EEETeamMinion/Year1Project/Magnetism/hall_sensor_absent.jpg

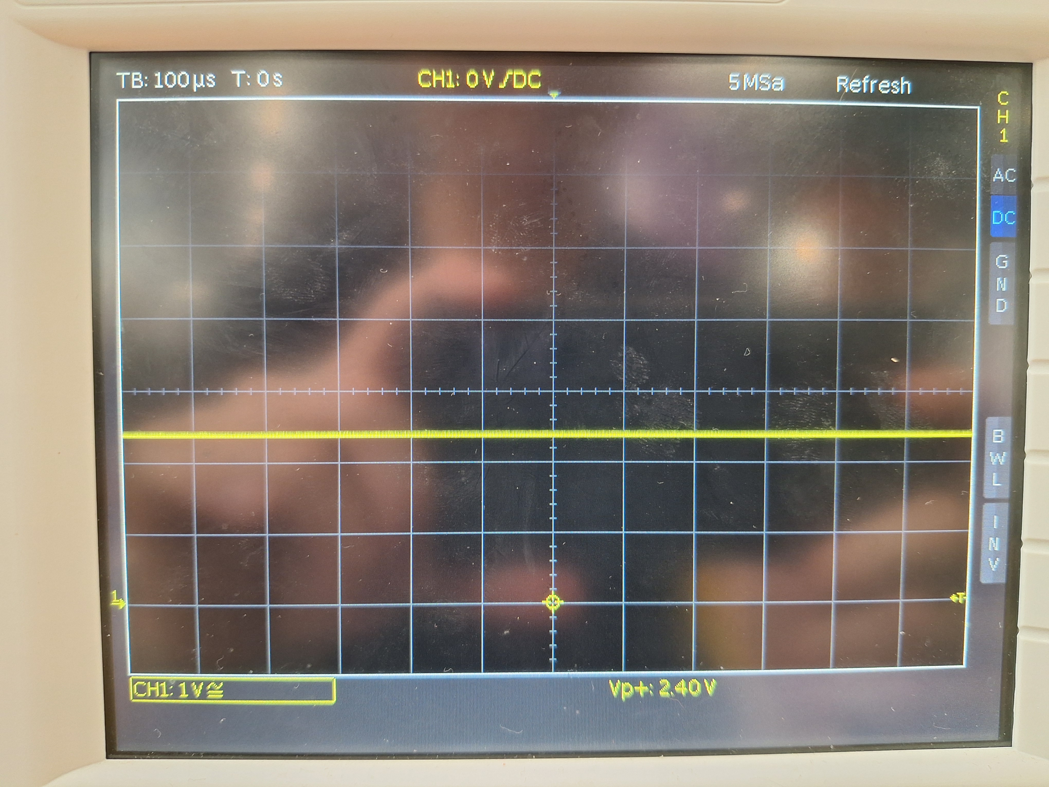
Magnetism/hall_sensor_absent.jpg
