EEETeamMinion/Year1Project/Magnetism/hall_sensor_down.jpg

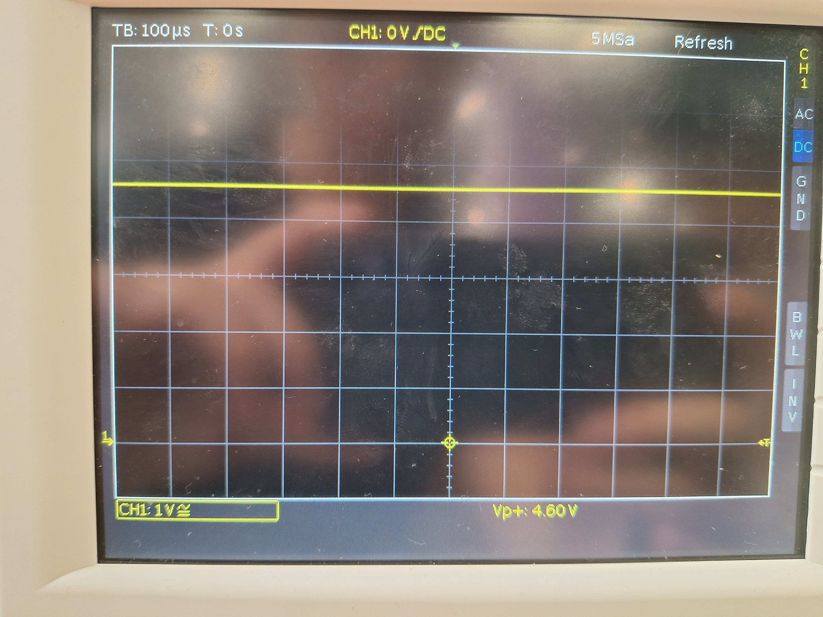
Magnetism/hall_sensor_down.jpg
