EEETeamMinion/Year1Project/Magnetism/hall_sensor_up.jpg

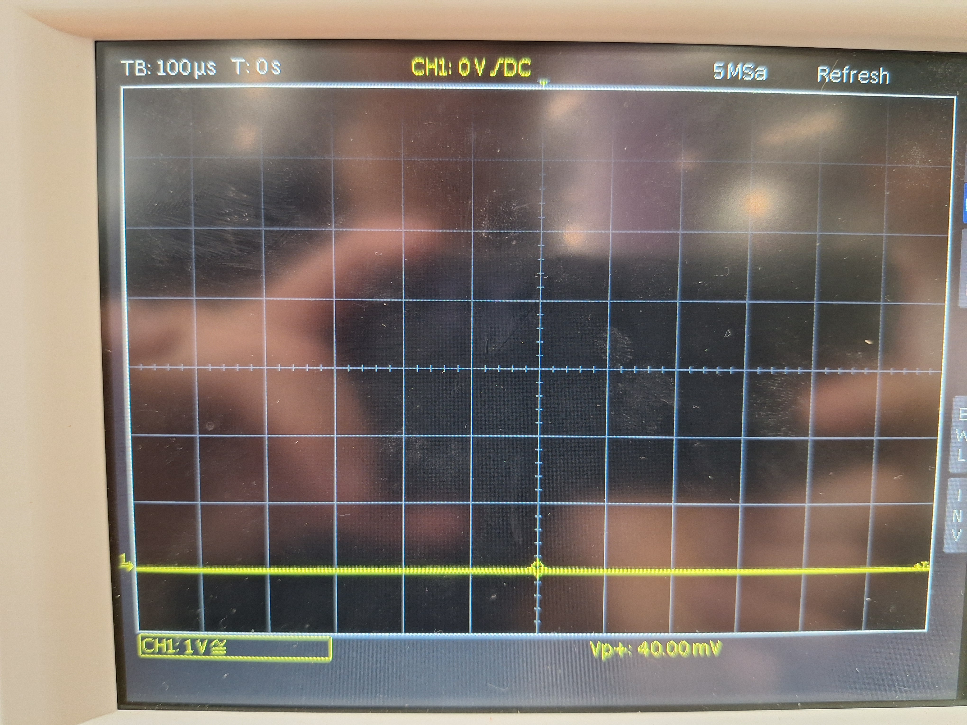
Magnetism/hall_sensor_up.jpg
