EEETeamMinion/Year1Project/Magnetism/summer project - magnetism schmitt trigger (final).asc

C1: cap; 100n
R3: res; 5.1k
R4: res; 5.1k
Rf: res; 2Meg
Rin: res; 10k
U1: LT1366
V1: voltage; 3.3
Vcc: voltage; 5
Vin: voltage; SINE(2.5 2.25 100)
Named nets: 0, Vout
.tran 100m
