EEETeamMinion/Year1Project/Magnetism/summer project - magnetism schmitt trigger (initial).asc

R3: res; 5.1k
R4: res; 5.1k
Rf: res; 150k
Rin: res; 10k
U1: LT1366
V1: voltage; 3
Vcc: voltage; 5
Vin: voltage; SINE(2.5 2.25 100)
Named nets: 0, Vout
.tran 100m
