EEETeamMinion/Year1Project/Ultrasound/Amplification.asc

R1: res; 1k
R2: res; 150k
U1: UniversalOpAmp
V1: voltage; SINE(0 20m 40000); AC 1
V2: voltage; 5
Named nets: 0, Vout
.tran 1m
