EEETeamMinion/Year1Project/Ultrasound/Bandpass filter ultrasound.asc

C1: cap; 1n
C2: cap; 1n
R1: res; 4.3k
R2: res; 3.9k
V1: voltage; ""; AC 1
Named nets: Vout, 0
.ac dec 100 10 100k
