EEETeamMinion/Year1Project/Ultrasound/Comparator.asc

R1: res; 12k
R2: res; 1k
R3: res; 390k
R4: res; 10k
R5: res; 2k
R6: res; 3k
U1: LT1366
V1: voltage; SINE(0 3 10); AC 1
V2: voltage; 5
Named nets: 0
.tran 0.5
.ac dec 100 10 100k
