EEETeamMinion/Year1Project/Ultrasound/Envelope Detector.asc

C1: cap; 10n
D1: diode; 1N4148
R1: res; 10k
V1: voltage; SINE(0 1 40000)
Named nets: 0, Vout
.tran 120u
