EEETeamMinion/Year1Project/Ultrasound/Full wave precision rectifier.asc

D1: diode; 1N4148
D2: diode; 1N4148
R1: res; 6.8k
R2: res; 6.8k
R3: res; 3.4k
R4: res; 6.8k
R5: res; 6.8k
U1: UniversalOpAmp
U2: UniversalOpAmp
V1: voltage; SINE(0 1 1000)
V2: voltage; 5
Named nets: 0, Vout
Gain of first opamp is R5/R3
Gain of second opamp is R5/R4
Total gain is sum of gains
This is set as an inverting amplifier
Requires high slew rate opamp (> 1V/us)
If input is X, we get:
Y = -(-(R5/R3)X + (R5/R4)X)
.tran 5m
