EEETeamMinion/Year1Project/Ultrasound/Sallen Key Filter.asc

C1: cap; 1n
C2: cap; 1n
C3: cap; 1n
C4: cap; 1n
R1: res; 4300
R2: res; 4300
R3: res; 3900
R4: res; 3900
U1: UniversalOpAmp
U2: UniversalOpAmp
V1: voltage; ""; AC 1
V2: voltage; 5
Named nets: 0, Vout
.ac dec 100 10 100k
