EEETeamMinion/Year1Project/Ultrasound/Ultrasonic Full Circuit Double Amplifier.asc

C1: cap; 1n
C2: cap; 1n
C3: cap; 10n
D1: diode
R1: res; 100k
R2: res; 1k
R3: res; 4.3k
R4: res; 3.9k
R5: res; 10k
R6: res; 9.1k
R7: res; 1k
R8: res; 47k
R9: res; 3k
R10: res; 180k
R11: res; 3k
R12: res; 2k
R13: res; 3k
U1: UniversalOpAmp
U2: UniversalOpAmp
U3: LT1366
V1: voltage; SINE(0 35m 40000); AC 1
V2: voltage; 5
V3: voltage; 5
Named nets: 0, Vamp, Vrect, Vout
.tran 250u
