EEETeamMinion/Year1Project/Ultrasound/Ultrasonic Full Circuit FINAL.asc

C1: cap; 0.1n
C2: cap; 0.1n
C3: cap; 10n
D1: diode
R1: res; 99k
R2: res; 1k
R3: res; 43k
R4: res; 39k
R5: res; 10k
R6: res; 16k
R7: res; 1k
R8: res; 390k
R9: res; 10k
R10: res; 2k
R11: res; 3k
U1: UniversalOpAmp
U2: LT1366
V1: voltage; SINE(0 35m 40000); AC 1
V2: voltage; 5
V4: voltage; 5
Named nets: 0, Vamp, Vrect, Vout
.tran 250u
