EEETeamMinion/Year1Project/Ultrasound/Ultrasonic Full Circuit v4.asc

C1: cap; 0.1n
C2: cap; 0.1n
C3: cap; 10n
D1: diode; 1N4148
D2: diode; 1N4148
R1: res; 49k
R2: res; 1k
R3: res; 43k
R4: res; 39k
R5: res; 6.8k
R6: res; 6.8k
R7: res; 3.4k
R8: res; 6.8k
R9: res; 6.8k
R10: res; 10k
U1: UniversalOpAmp
U2: UniversalOpAmp
U3: UniversalOpAmp
V1: voltage; SINE(0 35m 40000); AC 1
V2: voltage; 5
V4: voltage; 5
Named nets: 0, Vamp, Vout
.tran 250u
