EEETeamMinion/Year1Project/Ultrasound/Ultrasonic Full Circuit.asc

C1: cap; 0.1n
C2: cap; 0.1n
D1: diode; 1N4148
D2: diode; 1N4148
R1: res; 9k
R2: res; 1k
R3: res; 45k
R4: res; 35k
R5: res; 6.8k
R6: res; 6.8k
R7: res; 3.4k
R8: res; 6.8k
R9: res; 6.8k
R10: res; 9k
R11: res; 1k
U1: UniversalOpAmp
U2: UniversalOpAmp
U3: UniversalOpAmp
U4: UniversalOpAmp
V1: voltage; SINE(0 1 40000); AC 1
V2: voltage; 5
V3: voltage; 5
V4: voltage; 5
Named nets: 0, Vamp, Vout
.tran 250u
.ac dec 100 10 100k
