EEETeamMinion/Year1Project/infrared/LTSpice/200x amplification.asc

C1: cap; 1µ
R1: res; 1k
R2: res; 200k
R3: res; 10k
U1: LT1366
V1: voltage; 5
V2: voltage; PULSE(0 20mV 0 0.00001 0.00001 50u 0.01)
V3: voltage; 5
Named nets: 0, Vout
.tran 0.1
