EEETeamMinion/Year1Project/infrared/LTSpice/IR circuit FINAL.asc

C1: cap; 1µ
R7: res; 1k
R8: res; 1k
R10: res; 11k
R11: res; 200k
R12: res; 10k
R15: res; 10k
R16: res; 10k
R17: res; 240k
R18: res; 10k
U3: LT1366
U4: LT1366
V2: voltage; 5
V3: voltage; 5
V6: voltage; PULSE(0 20mV 0 0.00001 0.00001 50u 0.01)
Named nets: 0, vout
.tran 0.1
