EEETeamMinion/Year1Project/infrared/LTSpice/schmitt trigger.asc

R1: res; 1k
R2: res; 11k
R3: res; 10k
R4: res; 10k
R5: res; 10k
R6: res; 240k
U1: LT1366
V1: voltage; 5
Named nets: 0, vout, Vin
