EEETeamMinion/Year1Project/SummerProjectSensorBoard/SummerProjectSensorBoard.kicad_pcb

## KiCad design SummerProjectSensorBoard/SummerProjectSensorBoard.kicad_pcb (2026-06-11)

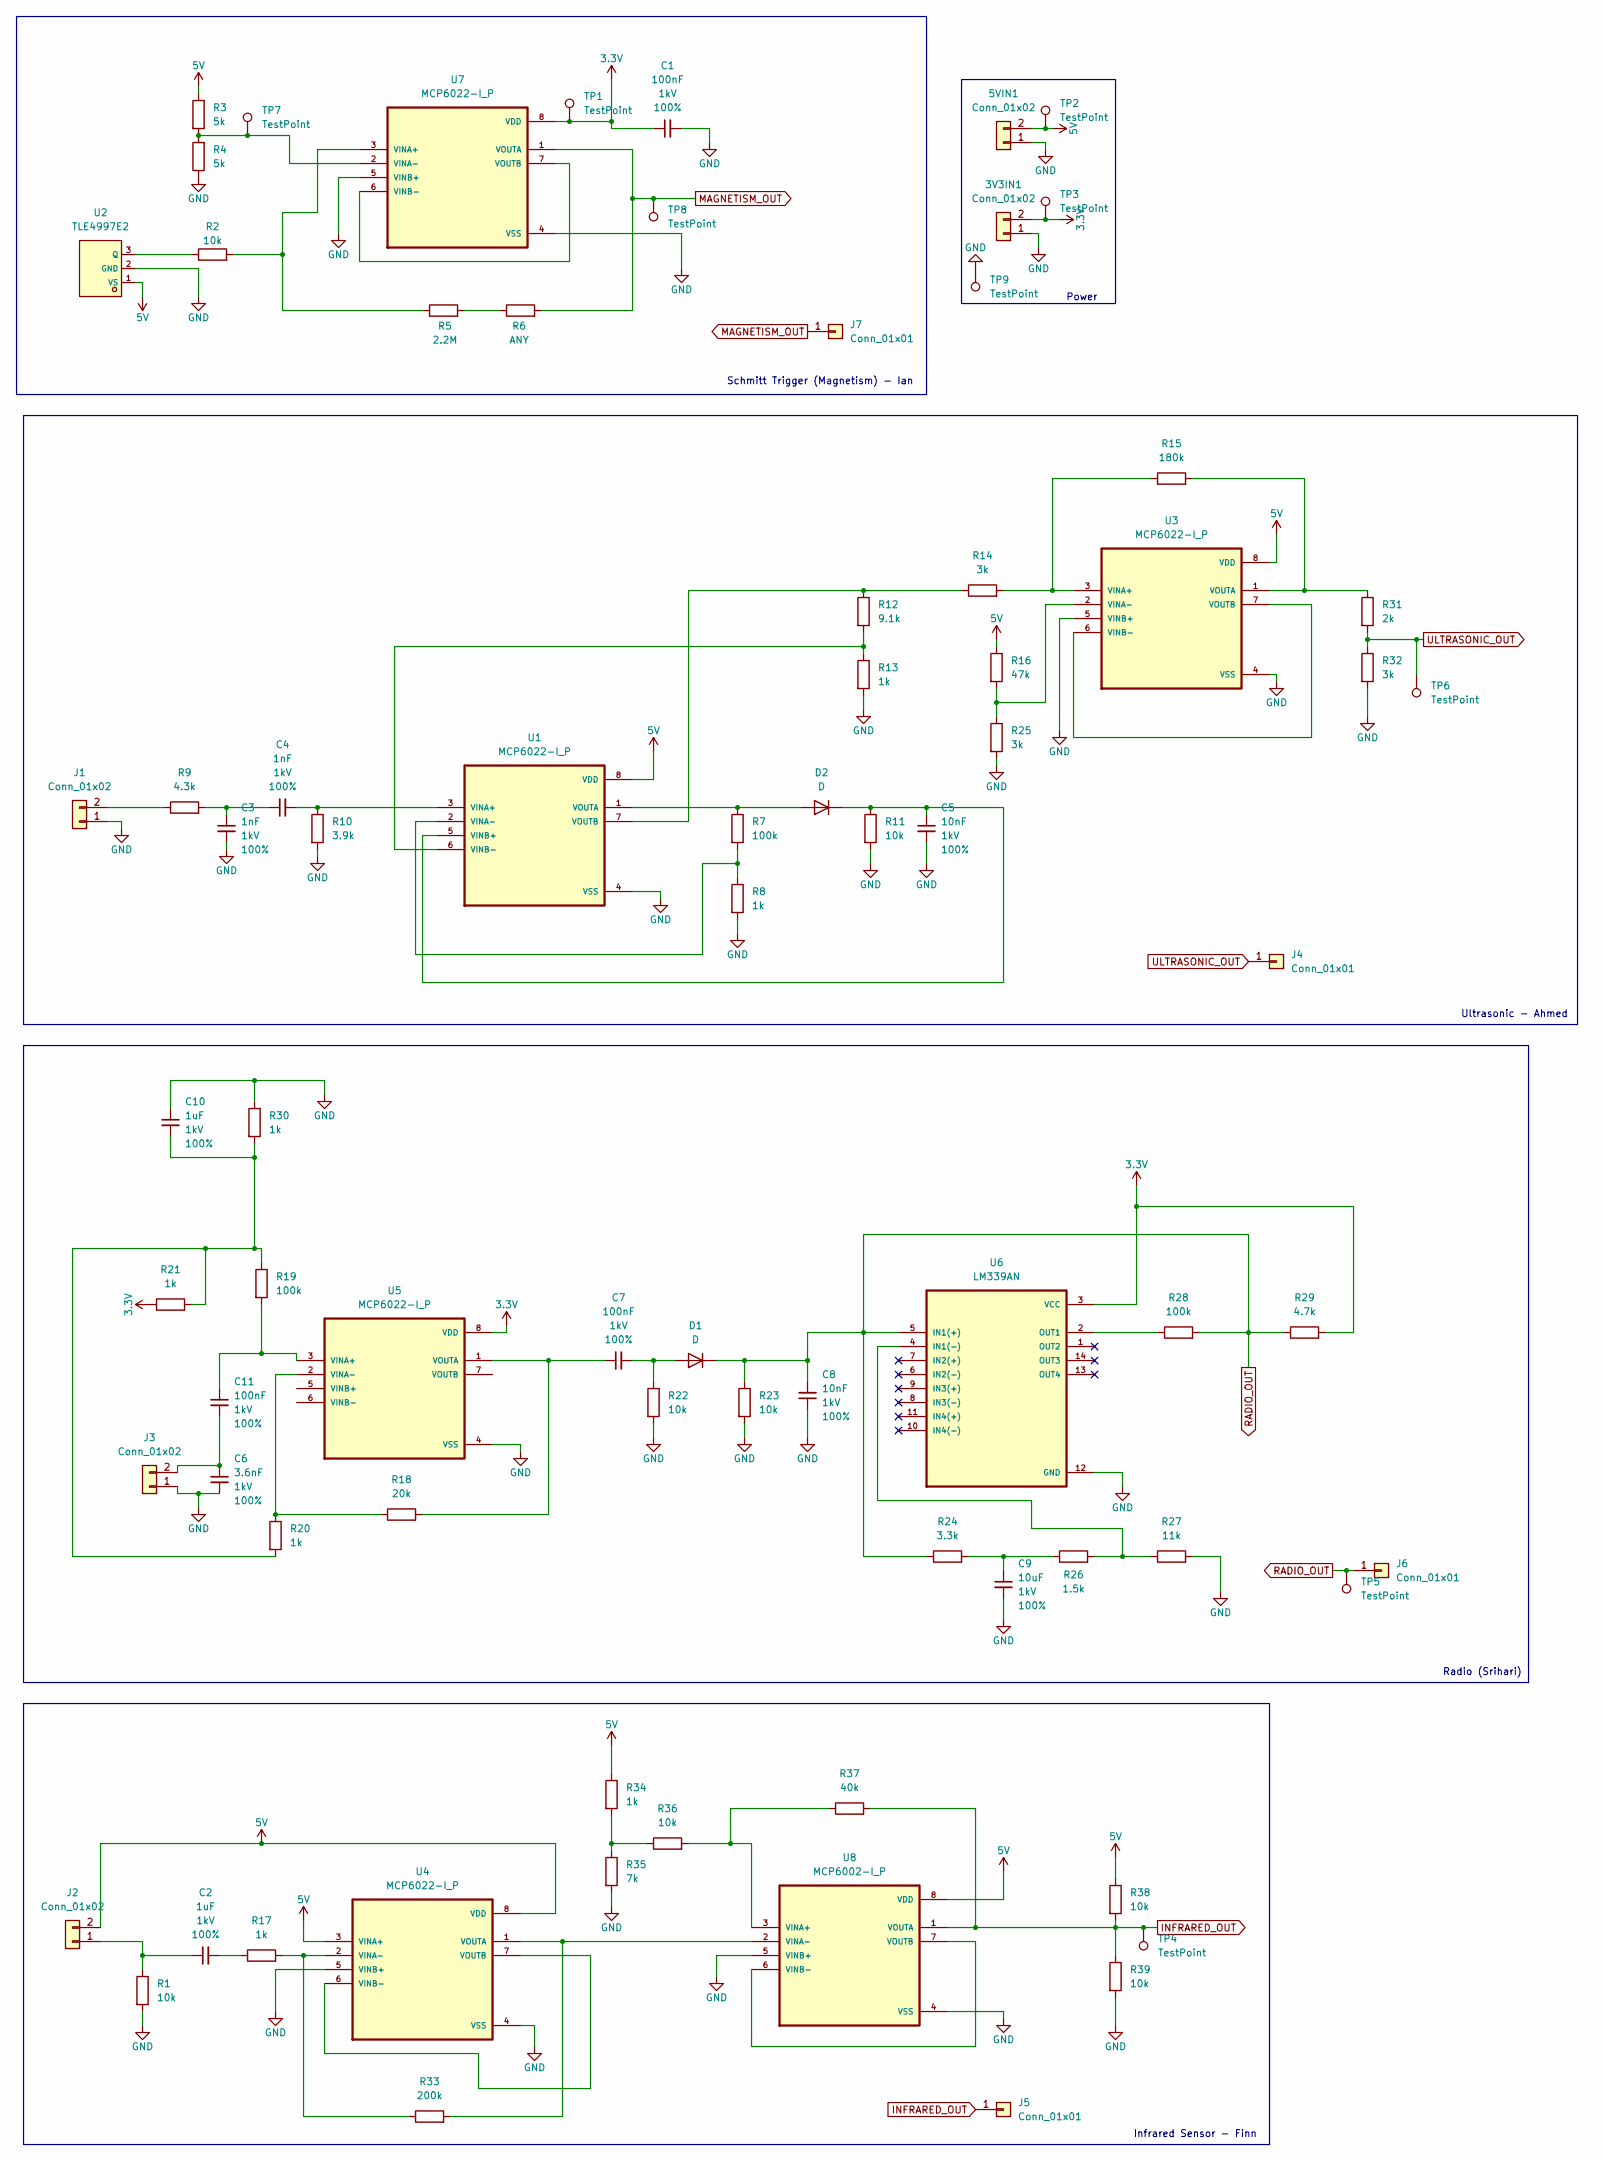
[picture p4: schematic SummerProjectSensorBoard.kicad_sch, EEELunarRover Sensor Board, part in row 1, column 1]

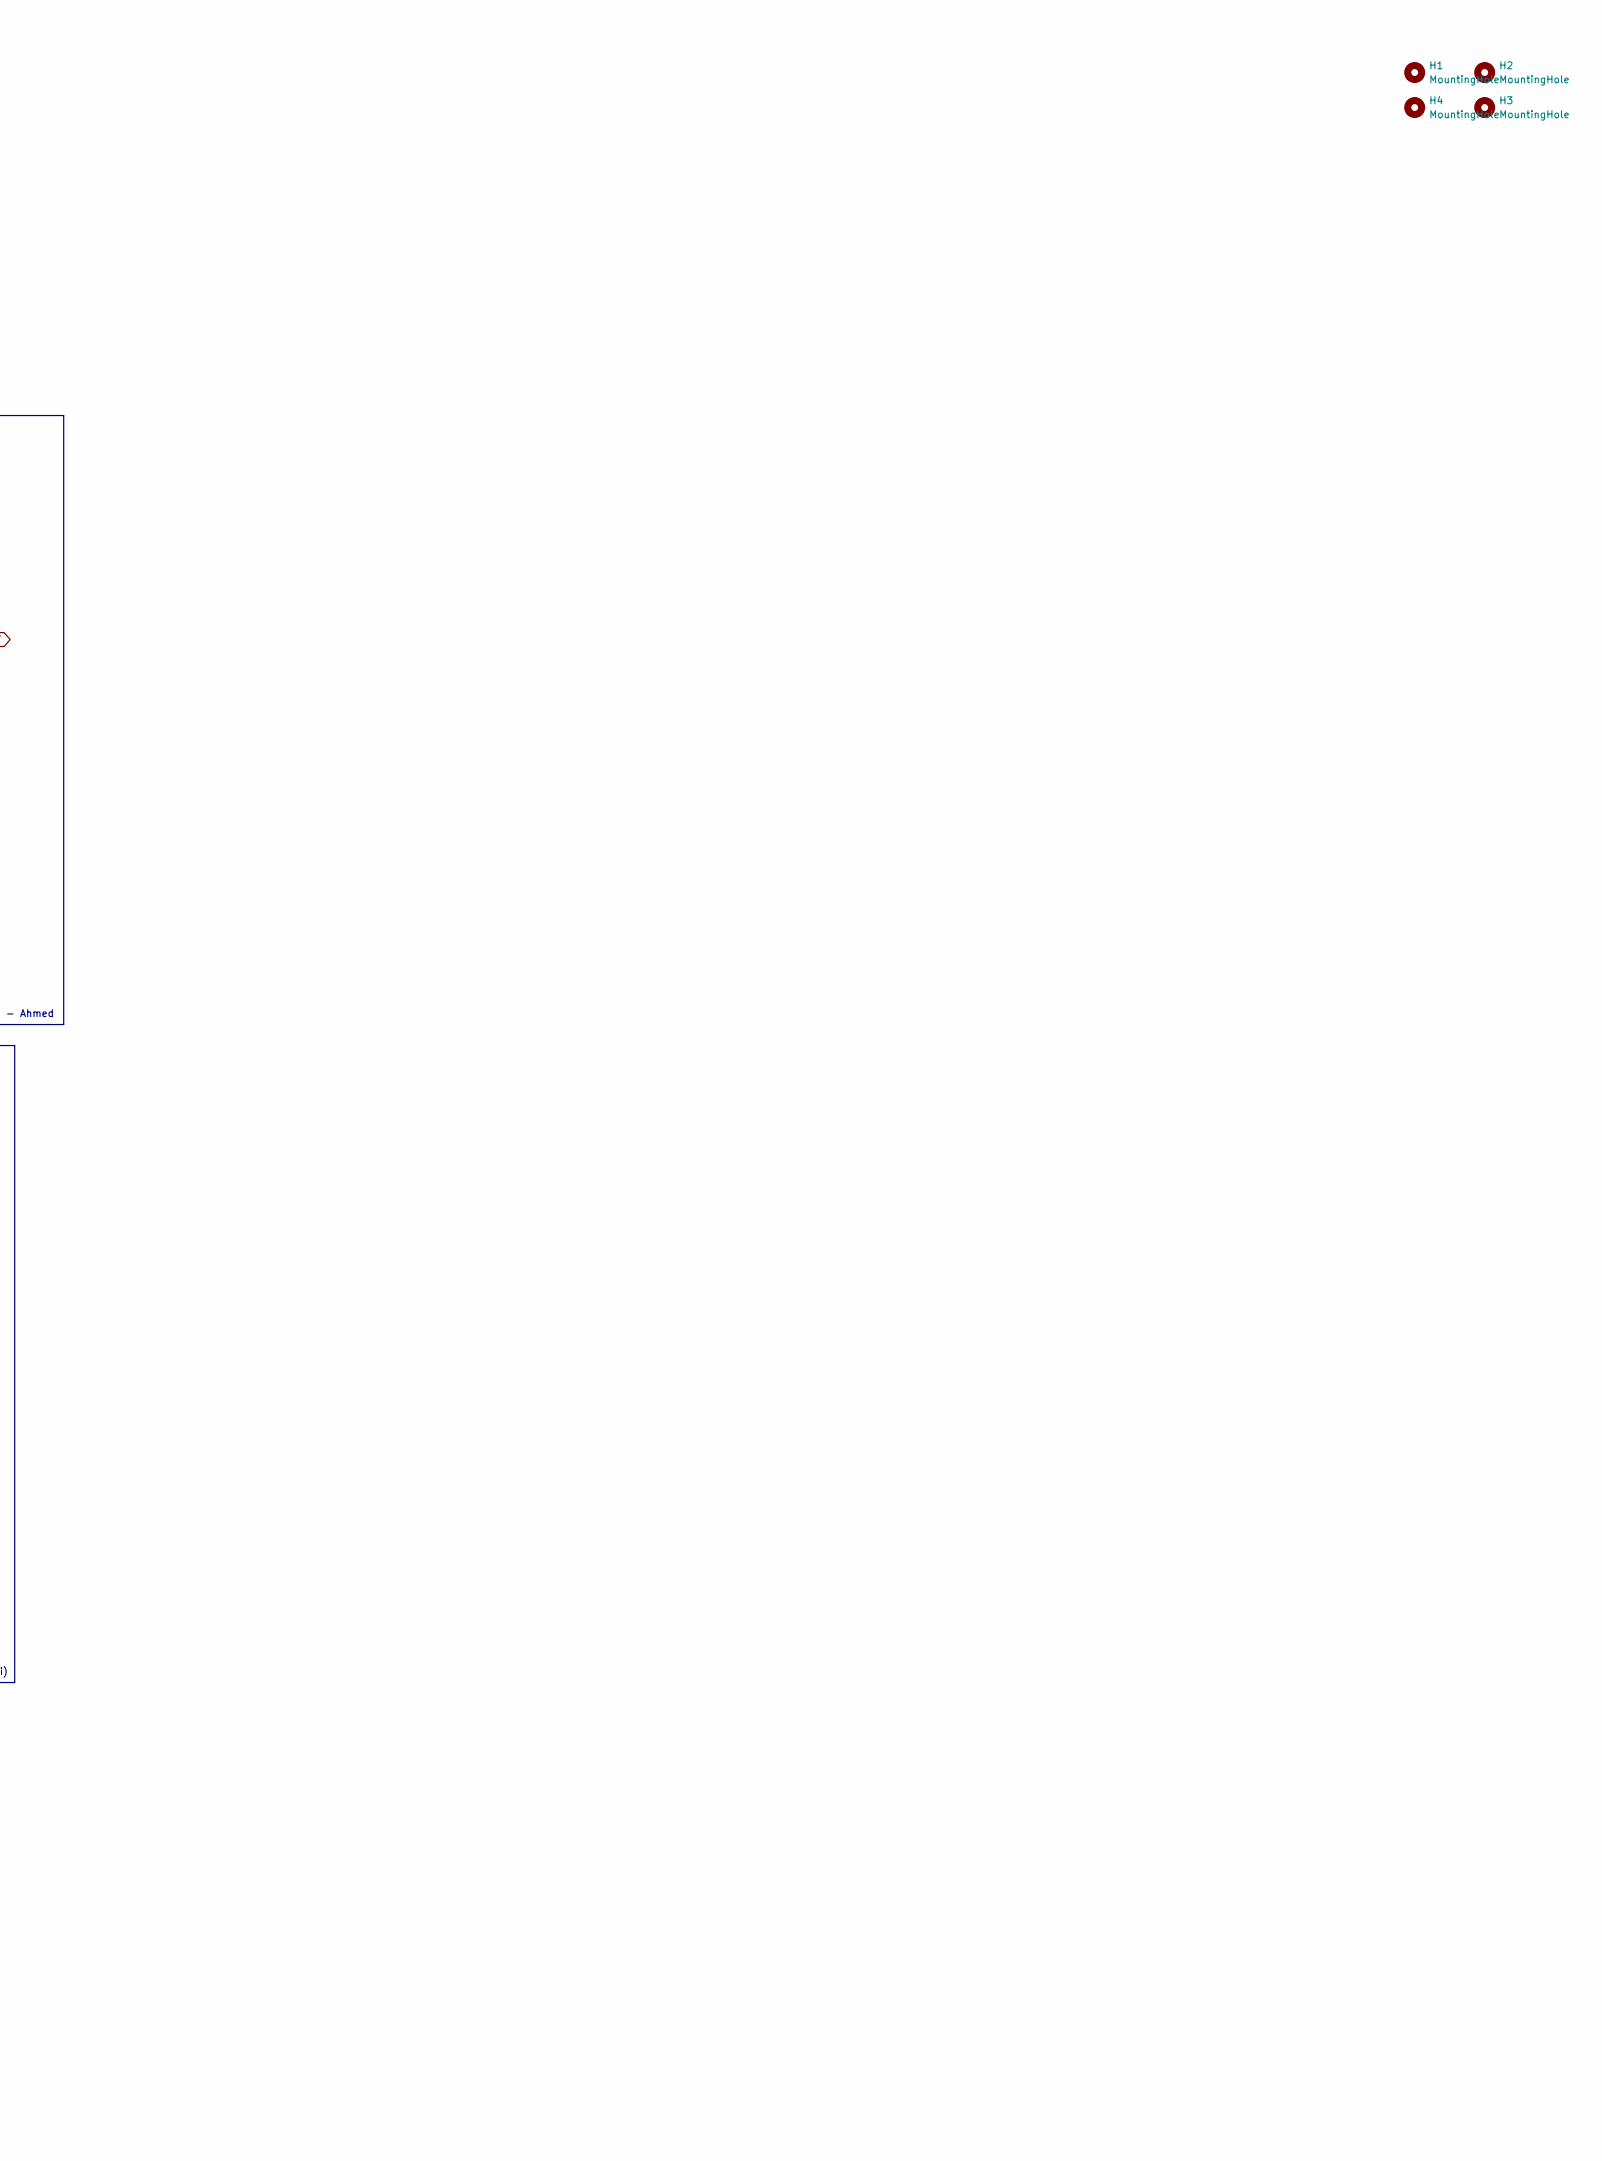
[picture p5: schematic SummerProjectSensorBoard.kicad_sch, EEELunarRover Sensor Board, part in row 1, column 2]

Parts:
3V3IN1, 5VIN1: Conn_01x02; JST_EH_B2B-EH-A_1x02_P2.50mm_Vertical
C1, C7, C11: 100nF; C_Disc_D5.0mm_W2.5mm_P2.50mm; Voltage 1kV; Tolerance 100%
C2: 1uF; C_Disc_D5.0mm_W2.5mm_P2.50mm; Voltage 1kV; Tolerance 100%
C3, C4: 1nF; C_Disc_D5.0mm_W2.5mm_P2.50mm; Voltage 1kV; Tolerance 100%
C5, C8: 10nF; C_Disc_D5.0mm_W2.5mm_P2.50mm; Voltage 1kV; Tolerance 100%
C6: 3.6nF; C_Disc_D5.0mm_W2.5mm_P5.00mm; Voltage 1kV; Tolerance 100%
C9: 10uF; C_Radial_D6.3mm_H5.0mm_P2.50mm; Voltage 1kV; Tolerance 100%
C10: 1uF; C_Radial_D6.3mm_H5.0mm_P2.50mm; Voltage 1kV; Tolerance 100%
D1, D2: D; D_5W_P10.16mm_Horizontal
H1, H2, H3, H4: MountingHole; MountingHole_3.2mm_M3
J1, J2, J3: Conn_01x02; JST_PH_B2B-PH-K_1x02_P2.00mm_Vertical
J4, J5, J6, J7: Conn_01x01; PinHeader_1x01_P1.00mm_Vertical
R1, R2, R11, R22, R23, R36, R38, R39: 10k; R_Axial_DIN0207_L6.3mm_D2.5mm_P7.62mm_Horizontal
R3, R4: 5k; R_Axial_DIN0207_L6.3mm_D2.5mm_P7.62mm_Horizontal
R5: 2.2M; R_Axial_DIN0207_L6.3mm_D2.5mm_P7.62mm_Horizontal
R6: ANY; R_Axial_DIN0207_L6.3mm_D2.5mm_P7.62mm_Horizontal
R7, R19, R28: 100k; R_Axial_DIN0207_L6.3mm_D2.5mm_P7.62mm_Horizontal
R8, R13, R17, R20, R21, R30, R34: 1k; R_Axial_DIN0207_L6.3mm_D2.5mm_P7.62mm_Horizontal
R9: 4.3k; R_Axial_DIN0207_L6.3mm_D2.5mm_P7.62mm_Horizontal
R10: 3.9k; R_Axial_DIN0207_L6.3mm_D2.5mm_P7.62mm_Horizontal
R12: 9.1k; R_Axial_DIN0207_L6.3mm_D2.5mm_P7.62mm_Horizontal
R14, R25, R32: 3k; R_Axial_DIN0207_L6.3mm_D2.5mm_P7.62mm_Horizontal
R15: 180k; R_Axial_DIN0207_L6.3mm_D2.5mm_P7.62mm_Horizontal
R16: 47k; R_Axial_DIN0207_L6.3mm_D2.5mm_P7.62mm_Horizontal
R18: 20k; R_Axial_DIN0207_L6.3mm_D2.5mm_P7.62mm_Horizontal
R24: 3.3k; R_Axial_DIN0207_L6.3mm_D2.5mm_P7.62mm_Horizontal
R26: 1.5k; R_Axial_DIN0207_L6.3mm_D2.5mm_P7.62mm_Horizontal
R27: 11k; R_Axial_DIN0207_L6.3mm_D2.5mm_P7.62mm_Horizontal
R29: 4.7k; R_Axial_DIN0207_L6.3mm_D2.5mm_P7.62mm_Horizontal
R31: 2k; R_Axial_DIN0207_L6.3mm_D2.5mm_P7.62mm_Horizontal
R33: 200k; R_Axial_DIN0207_L6.3mm_D2.5mm_P7.62mm_Horizontal
R35: 7k; R_Axial_DIN0207_L6.3mm_D2.5mm_P7.62mm_Horizontal
R37: 40k; R_Axial_DIN0207_L6.3mm_D2.5mm_P7.62mm_Horizontal
TP1, TP2, TP3, TP4, TP5, TP6, TP7, TP8, TP9: TestPoint; TestPoint_Pad_D1.5mm
U1, U3, U4, U5, U7: MCP6022-I_P; DIP787W46P254L927H533Q8
U2: TLE4997E2; C539897_PG-SSO-3-2_L4_2-W1_5-P1_27-L; LCSC C539897
U6: LM339AN; DIP794W45P254L1969H508Q14
U8: MCP6002-I_P; DIP787W46P254L927H533Q8

Connections:
3.3V: 3V3IN1.2, C1.1, R21.1, R29.2, TP1.1, TP3.1, U5.8 (VDD), U6.3 (VCC), U7.8 (VDD)
5V: 5VIN1.2, J2.2, R3.1, R16.1, R34.1, R38.1, TP2.1, U1.8 (VDD), U2.1 (VS), U3.8 (VDD), U4.3 (VINA+), U4.8 (VDD), U8.8 (VDD)
GND: 3V3IN1.1, 5VIN1.1, C1.2, C3.2, C5.2, C6.2, C8.1, C9.2, C10.1, J1.1, J3.1, R1.2, R4.1, R8.2, R10.2, R11.2, R13.2, R22.2, R23.2, R25.2, R27.2, R30.1, R32.2, R35.2, R39.2, TP9.1, U1.4 (VSS), U2.2 (GND), U3.4 (VSS), U3.5 (VINB+), U4.4 (VSS), U4.5 (VINB+), U5.4 (VSS), U6.12 (GND), U7.4 (VSS), U7.5 (VINB+), U8.4 (VSS), U8.5 (VINB+)
INFRARED_OUT: J5.1, R37.2, R38.2, R39.1, TP4.1, U8.1 (VOUTA)
MAGNETISM_OUT: J7.1, R6.2, TP8.1, U7.1 (VOUTA)
unnamed: C2.2, R17.1
unnamed: C3.1, C4.1, R9.2
unnamed: C9.1, R24.2, R26.1
unnamed: C10.2, R19.1, R20.2, R21.2, R30.2
unnamed: C7.2, D1.2 (A), R22.1
unnamed: D2.2 (A), R7.1, U1.1 (VOUTA)
unnamed: C5.1, D2.1 (K), R11.1, U1.5 (VINB+)
unnamed: J1.2, R9.1
unnamed: C2.1, J2.1, R1.1
unnamed: C6.1, C11.2, J3.2
unnamed: R5.2, R6.1
unnamed: R34.2, R35.1, R36.1
unnamed: C4.2, R10.1, U1.3 (VINA+)
unnamed: R7.2, R8.1, U1.2 (VINA-)
unnamed: R12.2, R13.1, U1.6 (VINB-)
unnamed: R12.1, R14.1, U1.7 (VOUTB)
unnamed: R2.1, U2.3 (Q)
unnamed: R14.2, R15.1, U3.3 (VINA+)
unnamed: R16.2, R25.1, U3.2 (VINA-)
unnamed: U3.6 (VINB-), U3.7 (VOUTB)
unnamed: R15.2, R31.1, U3.1 (VOUTA)
unnamed: R17.2, R33.1, U4.2 (VINA-)
unnamed: U4.6 (VINB-), U4.7 (VOUTB)
unnamed: R33.2, U4.1 (VOUTA), U8.2 (VINA-)
unnamed: C11.1, R19.2, U5.3 (VINA+)
unnamed: R18.1, R20.1, U5.2 (VINA-)
unnamed: C7.1, R18.2, U5.1 (VOUTA)
unnamed: R26.2, R27.1, U6.4 (IN1(-))
unnamed: R28.1, U6.2 (OUT1)
unnamed: R2.2, R5.1, U7.3 (VINA+)
unnamed: R3.2, R4.2, TP7.1, U7.2 (VINA-)
unnamed: U7.6 (VINB-), U7.7 (VOUTB)
unnamed: R36.2, R37.1, U8.3 (VINA+)
unnamed: U8.6 (VINB-), U8.7 (VOUTB)
RADIO_OUT: C8.2, D1.1 (K), J6.1, R23.1, R24.1, R28.2, R29.1, TP5.1, U6.5 (IN1(+))
ULTRASONIC_OUT: J4.1, R31.2, R32.1, TP6.1

Notes on the sheet:
Radio (Srihari)
Power
Infrared Sensor - Finn
Ultrasonic - Ahmed
Schmitt Trigger (Magnetism) - Ian

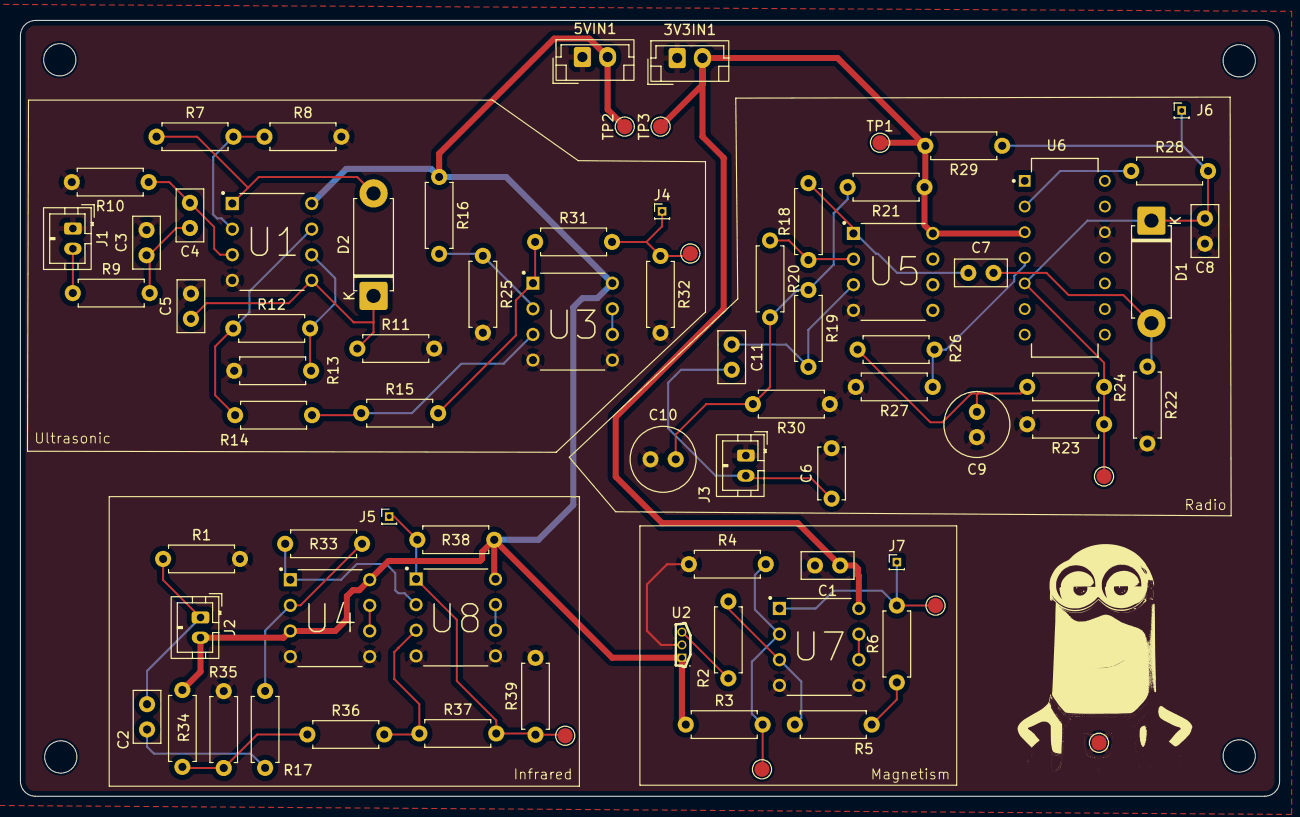
[picture p6: board SummerProjectSensorBoard.kicad_pcb from above]

Board: 2 copper layers, 124.8 x 76.9 mm, 82 parts (0 on the bottom side), 41 nets.
