EEETeamMinion/Year1Project/(commit log)

2026-05-13 Add files via upload
    Here is the breakdown of the antennae being built
2026-05-13 Update Building the Antennae.md
    Editing latex
2026-06-10 Create Magnetism
2026-06-16 Rename Building the Antennae.md to Radio/Building the Antennae.md
